Varriun/mag_deck/CAD_outshell/WhatsApp Image 2026-05-17 at 13.24.43.jpeg

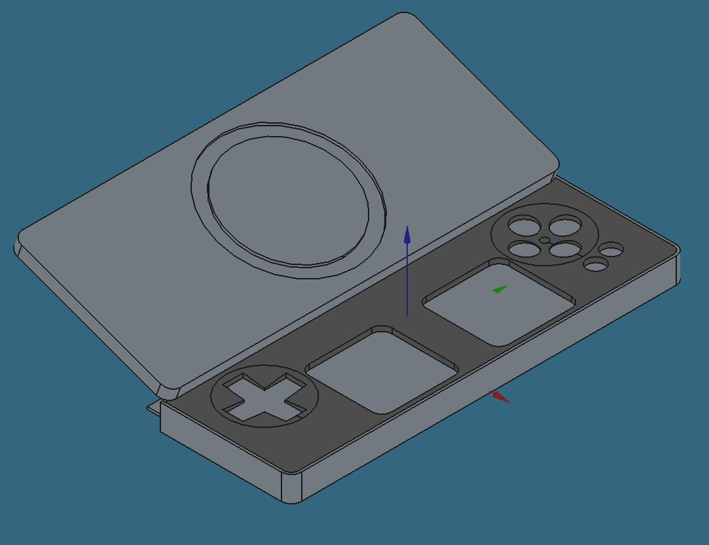
CAD_outshell/WhatsApp Image 2026-05-17 at 13.24.43.jpeg
