Varriun/mag_deck/mag_deck_v2_BOM.xlsx

mag_deck v2 — Bill of Materials (single-unit prototype)
Prices are single/low-qty hobbyist pricing (Digikey/Mouser/LCSC/keycapsss/Amazon), Aug 2026. Bulk pricing will be significantly lower. See Notes column for sourcing.
Module | Item | Part No. / Source | Qty | Unit Price (USD) | Subtotal (USD) | Notes
Bottom Module (Input / Trackpad Board)
Bottom | Cirque GlidePoint Circle Trackpad, 35mm, I2C variant (incl. FFC cable + I2C adapter PCB) | KC10079_35-C (keycapsss.com) | 2 | $23.50 | $47.00 | I2C addr fixed 0x2A / 0x2C via resistor mod — matches existing RTL. Confirm onboard click-button GPIO pins for L3/R3 in full Pinnacle datasheet before finalizing.
Bottom | 16-bit I2C GPIO expander (buttons) | MCP23017-E/SO (Digikey) | 1 | $1.62 | $1.62 | Reads all 14 discrete buttons over I2C; frees the connector from parallel GPIO lines.
Bottom | Tactile momentary switches — ABXY(4), D-pad(4), bumpers(2), triggers(2), start/select(2) | Generic SMD tactile switch | 14 | $0.15 | $2.10 | L3/R3 click is NOT here — comes from Cirque Pinnacle's own button pins, not the expander.
Bottom | Board-to-board pogo pin connector (4–5 pin: VCC/GND/SDA/SCL/+INT) | TBD — pending connector spec (Task 1) | 1 | $2.50 | $2.50 | Mates across the slide/hinge joint to top module.
Bottom | Bottom module PCB fab (lot of 5) | TBD fab house (JLCPCB-class) | 1 | $8.00 | $8.00 | Per-board cost amortized from a small fab run.
Top Module (BLE MCU / Power Board)
Top | nRF52840 BLE module | Raytac MDBT50Q-P1MV2 (Digikey) | 1 | $6.00 | $6.00 | Pre-certified module — avoids RF layout/certification risk of a bare-chip design.
Top | N52 ring magnet array (MagSafe-style attach) | Generic N52 ring magnet set | 1 | $6.00 | $6.00 | For phone attachment, separate from board-to-board connector magnets (if used).
Top | 32.768kHz crystal (BLE low-frequency clock) | Generic tuning-fork crystal, 12.5pF | 1 | $0.30 | $0.30 | Improves BLE timing accuracy/power vs. internal RC oscillator.
Top | Passives (decoupling caps, antenna matching network, pull-ups) | Assorted 0402/0603 passives | 1 | $3.00 | $3.00 | Lumped estimate — refine once schematic is placed.
Top | Power switch | Generic SMD slide/tactile power switch | 1 | $0.60 | $0.60 | Optional now that there is no battery to gate — just an on/off for the USB-powered board. Confirm still wanted before ordering.
Top | Top module PCB fab (lot of 5) | TBD fab house (JLCPCB-class) | 1 | $8.00 | $8.00 | Per-board cost amortized from a small fab run.
 |  |  |  | TOTAL (single prototype unit) | $85.12
