Varriun/mag_deck/CAD/backPlate.FCStd

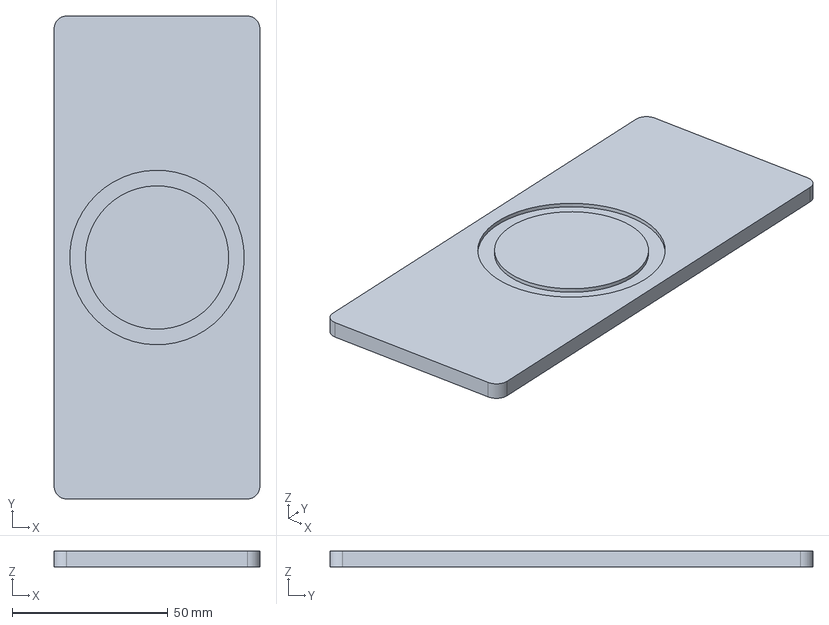
[picture p3: CAD file, 2026-11-06]
CAD/backPlate.FCStd
66.0 x 155.0 x 5.00 mm
