Varriun/mag_deck/CAD/MCON_Fold8_Mockup-DeployPlate.stl

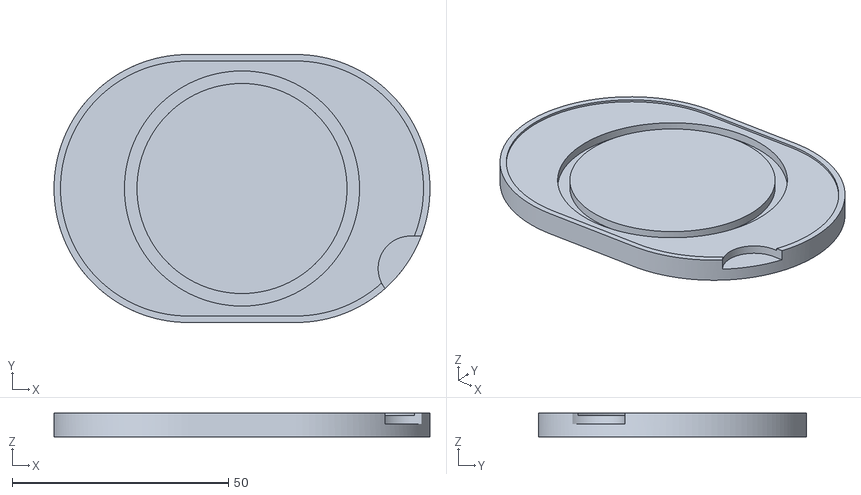
[picture p4: CAD file, 2026-11-06]
CAD/MCON_Fold8_Mockup-DeployPlate.stl
87.0 x 62.0 x 5.50
