Varriun/mag_deck/CAD/shell.FCStd

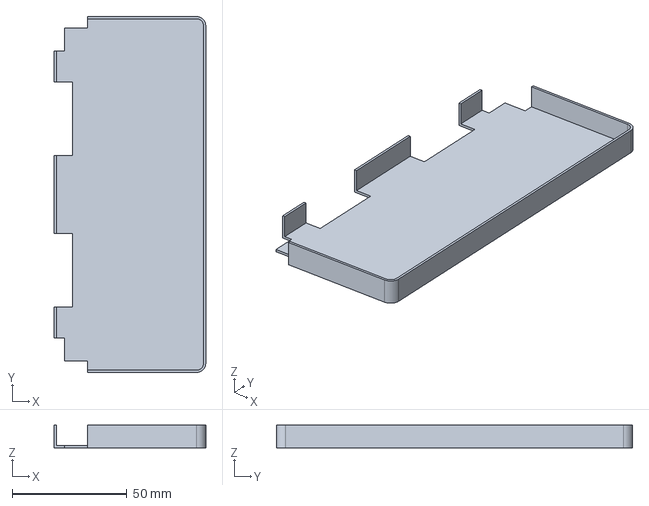
[picture p5: CAD file, 2026-11-06]
CAD/shell.FCStd
66.0 x 155.0 x 10.0 mm
