Varriun/mag_deck/CAD/MCON_Fold8_Mockup.FCStd

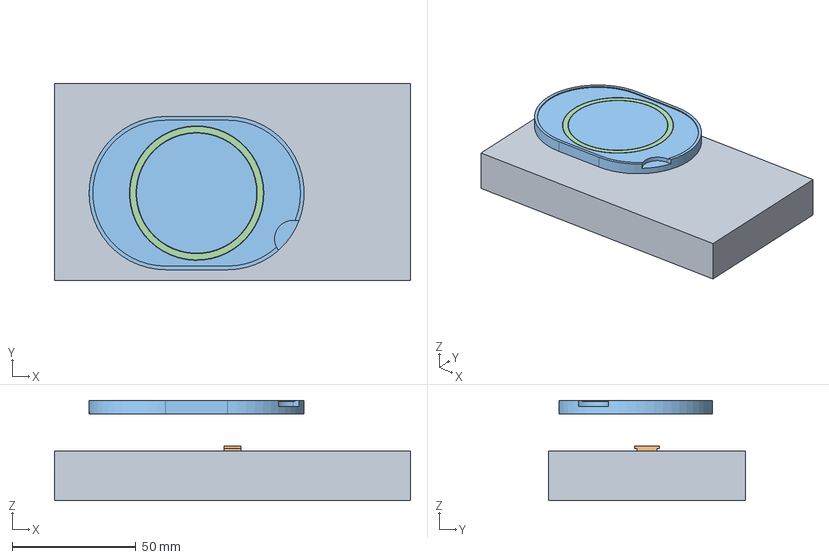
[picture p6: CAD file, 2026-11-06]
CAD/MCON_Fold8_Mockup.FCStd
144.0 x 79.5 x 40.5 mm
Controller
GripNub
Plate
MagnetRing
