Varriun/mag_deck/CAD/frontPlate.FCStd

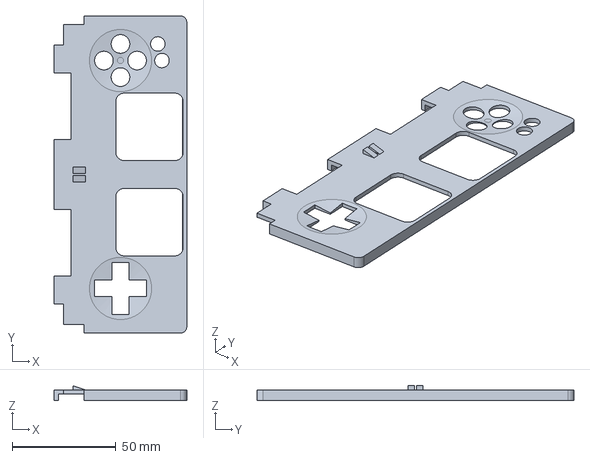
[picture p7: CAD file, 2026-11-06]
CAD/frontPlate.FCStd
64.0 x 153.0 x 7.00 mm
