Varriun/mag_deck/CAD/MCON_Fold8_Mockup6.FCStd

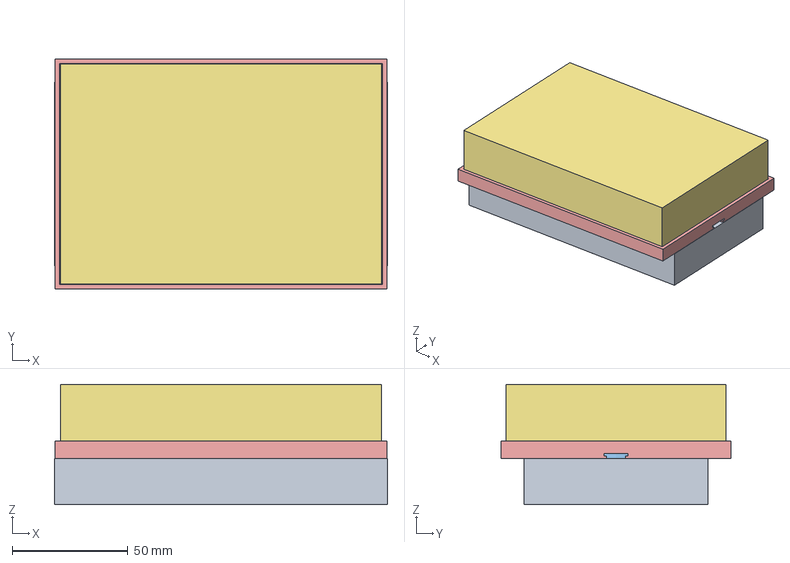
[picture p8: CAD file, 2026-11-06]
CAD/MCON_Fold8_Mockup6.FCStd
144.0 x 99.6 x 52.0 mm
Controller
GripNub
StockPuck
StockPuckRing
Plate
MagnetRing
Fold8Case
CameraBump
