Varriun/mag_deck/(list of files, cad)

Other CAD files:
CAD/controller.FCStd
CAD/faceButton.FCStd
CAD/dpad.FCStd
CAD/bumper.FCStd
