Varriun/mag_deck/(list of files, drawings)

Other design files:
PCB_Project/MAGDECK.SchDoc
PCB_Project/PCB_Project.PrjPcb
