Varriun/mag_deck/testBenches/core_boot_tb.sv

`default_nettype none
// Testbench-only: plain `always` (clock/monitors) and `===` (X-aware checks)
// are correct here; these two rules target synthesizable RTL.
/* svlint off keyword_forbidden_always */
/* svlint off operator_case_equality */
`timescale 1ns/1ps

// ─────────────────────────────────────────────────────────────────────────────
// Integration testbench for mag_deck_core
// Exercises the full pipeline: buttons → debounce → input_mapper → tx_encoder → uart_tx
//
// HOW TO COMPILE AND RUN (from the mag_deck directory):
//   iverilog -g2012 -o core_sim.vvp \
//     testBenches/core_boot_tb.sv \
//     unit/mag_deck_core.sv unit/debounce.sv unit/i2c_master.sv \
//     unit/input_mapper.sv unit/tx_encoder.sv unit/uart_tx.sv
//   vvp core_sim.vvp
//   gtkwave core_boot.vcd
//
// WHAT TO LOOK FOR IN GTKWAVE:
//   dut.clean_face_btn     — settles after THRESHOLD cycles from stable press
//   dut.poll_tick          — pulses every 500K cycles (10 ms)
//   i2c_scl_1 / i2c_scl_2 — toggle after each poll_tick (masters start transaction)
//   tx_pin                 — UART frames appear after each poll_tick
//   dut.enc.state          — steps IDLE→START→WAIT×5→IDLE per packet
//   dut.uart.state         — steps IDLE→START→DATA→STOP per byte
// ─────────────────────────────────────────────────────────────────────────────

module core_boot_tb();

  // ── Parameters ────────────────────────────────────────────────────────────
  localparam int CLK_FREQ        = 50_000_000;
  localparam int BAUD_RATE       = 115_200;
  localparam int DIVISOR         = CLK_FREQ / BAUD_RATE;  // 434 cycles per bit
  localparam int HALF_BIT        = DIVISOR / 2;            // 217
  localparam int DEBOUNCE_THRESH = 50_000;

  // ── Inputs ────────────────────────────────────────────────────────────────
  logic       clk        = 1'b0;
  logic       rst_n      = 1'b0;
  logic [3:0] face_btn   = 4'b0000;
  logic [3:0] dpad       = 4'b0000;
  logic [1:0] bumpers    = 2'b00;
  logic       start_btn  = 1'b0;
  logic       select_btn = 1'b0;
  logic [1:0] triggers   = 2'b00;

  // ── I2C ───────────────────────────────────────────────────────────────────
  // pullup models the physical pull-up resistors on the I2C bus.
  // No slave is modelled — masters will attempt transactions and see NACK.
  logic i2c_scl_1, i2c_scl_2;
  tri   i2c_sda_1, i2c_sda_2;
  pullup pu1 (i2c_sda_1);
  pullup pu2 (i2c_sda_2);

  // ── UART output ───────────────────────────────────────────────────────────
  logic tx_pin;

  // ── DUT ───────────────────────────────────────────────────────────────────
  mag_deck_core dut (
    .clk        (clk),
    .rst_n      (rst_n),
    .face_btn   (face_btn),
    .dpad       (dpad),
    .bumpers    (bumpers),
    .start_btn  (start_btn),
    .select_btn (select_btn),
    .triggers   (triggers),
    .i2c_scl_1  (i2c_scl_1),
    .i2c_sda_1  (i2c_sda_1),
    .i2c_scl_2  (i2c_scl_2),
    .i2c_sda_2  (i2c_sda_2),
    .tx_pin     (tx_pin)
  );

  // ── 50 MHz clock ──────────────────────────────────────────────────────────
  always #10 clk = ~clk;

  // ── Diagnostics ───────────────────────────────────────────────────────────
  always @(posedge dut.tx_start)
    $display("  DIAG  tx_start pulse: tx_byte=0x%02X  t=%0t", dut.tx_byte, $time);

  always @(negedge tx_pin)
    $display("  DIAG  tx_pin negedge  t=%0t", $time);

  // ── Task: capture one UART byte ───────────────────────────────────────────
  // Call immediately after @(negedge tx_pin) — enters at start of start bit.
  // Skips start bit, samples 8 data bits LSB-first at their midpoints,
  // then leaves sim position near midpoint of stop bit.
  task capture_uart_byte;
    output [7:0] captured;
    integer b;
    begin
      // Advance past start bit and to midpoint of bit 0
      repeat(DIVISOR + HALF_BIT) @(posedge clk); #1;
      // Sample 8 data bits, one bit period apart
      for (b = 0; b < 8; b = b + 1) begin
        captured[b] = tx_pin;
        repeat(DIVISOR) @(posedge clk); #1;
      end
      // Now near midpoint of stop bit — next @(negedge tx_pin) will sync to next byte
    end
  endtask

  // ── Scoreboard: check()/check_byte()/report_and_finish() + watchdog ──────
  // Full run is ~20.1 ms; the watchdog fails the test at 30 ms.
  localparam string TB_NAME    = "core_boot_tb";
  localparam int    TIMEOUT_NS = 30_000_000;
`include "testBenches/tb_checks.svh"

  // ── I2C activity monitor ──────────────────────────────────────────────────
  // Counts SCL rising edges so PHASE 9 can check the masters actually clocked
  // the bus, instead of sampling SCL once.
  int scl1_edges = 0;
  int scl2_edges = 0;
  always @(posedge i2c_scl_1) scl1_edges++;
  always @(posedge i2c_scl_2) scl2_edges++;
  int scl1_at_tick, scl2_at_tick;

  // ── Stimulus ──────────────────────────────────────────────────────────────
  logic [7:0] byte_cap;

  initial begin
    $dumpfile("core_boot.vcd");
    $dumpvars(0, core_boot_tb);

    // ── PHASE 1: Reset ────────────────────────────────────────────────────
    $display("\n── PHASE 1: Reset ──");
    rst_n = 1'b0;
    repeat(4) @(posedge clk);
    rst_n = 1'b1;
    repeat(2) @(posedge clk); #1;
    check(tx_pin === 1'b1, "tx_pin idle high after reset");

    // ── PHASE 2: Bounce then stable inputs ───────────────────────────────
    // Bounce on face_btn[1]; stable inputs settle on face_btn[0] + others.
    // Expected packet values:
    //   pkt[1] = {2'b0, triggers=01, start=1, select=0, bumpers=01} = 0x19
    //   pkt[2] = {face_btn=0001, dpad=0001}             = 0x11
    $display("\n── PHASE 2: Bounce + stable inputs ──");
    @(posedge clk); face_btn[1] = 1'b1;
    @(posedge clk); face_btn[1] = 1'b0;
    @(posedge clk); face_btn[1] = 1'b1;
    @(posedge clk); face_btn[1] = 1'b0;
    @(posedge clk);
    face_btn  = 4'b0001;
    dpad      = 4'b0001;
    bumpers   = 2'b01;
    start_btn = 1'b1;
    triggers  = 2'b01;
    $display("  Inputs: face=0001 dpad=0001 bumpers=01 start=1 triggers=01");

    // ── PHASE 3: Debounce settle ──────────────────────────────────────────
    $display("\n── PHASE 3: Debounce settle ──");
    repeat(DEBOUNCE_THRESH + 500) @(posedge clk); #1;
    check(dut.clean_face_btn === 4'b0001,
          $sformatf("clean_face_btn = %b (expected 0001, bounce filtered)",
                    dut.clean_face_btn));
    check(dut.clean_start_btn === 1'b1,
          $sformatf("clean_start_btn = %b (expected 1)", dut.clean_start_btn));

    // ── PHASE 4: Wait for poll_tick ───────────────────────────────────────
    // tx_pin goes low ~2 cycles after poll_tick — go straight to @(negedge)
    // with no added delay so we don't miss the first start bit.
    $display("\n── PHASE 4: Waiting for poll_tick ──");
    @(posedge dut.poll_tick);
    scl1_at_tick = scl1_edges;
    scl2_at_tick = scl2_edges;
    #1;
    $display("  poll_tick fired  pkt={0x%02X,0x%02X,0x%02X,0x%02X,0x%02X}",
             dut.pkt[0], dut.pkt[1], dut.pkt[2], dut.pkt[3], dut.pkt[4]);

    // ── PHASE 5: UART byte 0 — sync (0xAA) ───────────────────────────────
    $display("\n── PHASE 5: UART byte 0 (sync) ──");
    @(negedge tx_pin);
    capture_uart_byte(byte_cap);
    check_byte(byte_cap, 8'hAA, "byte[0] sync");

    // ── PHASE 6: UART byte 1 — buttons (0x19) ────────────────────────────
    $display("\n── PHASE 6: UART byte 1 (buttons) ──");
    @(negedge tx_pin);
    capture_uart_byte(byte_cap);
    check_byte(byte_cap, 8'h19, "byte[1] btns");

    // ── PHASE 7: UART byte 2 — face + dpad (0x11) ────────────────────────
    $display("\n── PHASE 7: UART byte 2 (face+dpad) ──");
    @(negedge tx_pin);
    capture_uart_byte(byte_cap);
    check_byte(byte_cap, 8'h11, "byte[2] face+dpad");

    // ── PHASE 8: UART bytes 3,4 — trackpad data ───────────────────────────
    // No I2C slave model — tp_data stays at 0x00 (reset value).
    $display("\n── PHASE 8: UART bytes 3,4 (trackpad, no slave) ──");
    @(negedge tx_pin);
    capture_uart_byte(byte_cap);
    check_byte(byte_cap, 8'h00, "byte[3] tp_data_1 (no slave)");

    @(negedge tx_pin);
    capture_uart_byte(byte_cap);
    check_byte(byte_cap, 8'h00, "byte[4] tp_data_2 (no slave)");

    // ── PHASE 9: I2C SCL activity ─────────────────────────────────────────
    // UART transmission just finished (~21K cycles since poll_tick).
    // I2C masters (100kHz, 500 cycles/bit) have had plenty of time to start.
    // Check SCL actually clocked since poll_tick (edge count, not one sample).
    $display("\n── PHASE 9: I2C SCL activity ──");
    repeat(10) @(posedge clk); #1;
    check(scl1_edges > scl1_at_tick,
          $sformatf("i2c_scl_1 clocked after poll_tick (%0d rising edges)",
                    scl1_edges - scl1_at_tick));
    check(scl2_edges > scl2_at_tick,
          $sformatf("i2c_scl_2 clocked after poll_tick (%0d rising edges)",
                    scl2_edges - scl2_at_tick));

    // ── PHASE 10: Pipeline idle check ────────────────────────────────────
    $display("\n── PHASE 10: Pipeline idle check ──");
    repeat(DIVISOR + 20) @(posedge clk); #1;
    check(dut.tx_busy === 1'b0, "tx_busy low — pipeline in IDLE");
    check(tx_pin === 1'b1,      "tx_pin idle high");

    // ── PHASE 11: Second packet on next poll_tick ─────────────────────────
    $display("\n── PHASE 11: Second packet ──");
    @(posedge dut.poll_tick);
    @(negedge tx_pin);
    capture_uart_byte(byte_cap);
    check_byte(byte_cap, 8'hAA, "pkt2 byte[0] sync");

    $display("\n── Integration sim complete ──");
    report_and_finish();
  end

endmodule

`default_nettype wire
