Varriun/mag_deck/testBenches/input_mapper_tb.sv

`default_nettype none
// Testbench-only: plain `always` (clock/monitors) and `===` (X-aware checks)
// are correct here; these two rules target synthesizable RTL.
/* svlint off keyword_forbidden_always */
/* svlint off operator_case_equality */
`timescale 1ns/1ps

// ─────────────────────────────────────────────────────────────────────────────
// Testbench for input_mapper.sv
//
// Three checks:
//   1. All-zeros: every data byte should be 0x00; pkt[0] always 0xAA.
//   2. Known pattern: drive recognisable values, verify each byte by hand.
//   3. pkt_valid strobe: assert poll_tick for one cycle, confirm pkt_valid
//      goes high for exactly that cycle then returns to 0.
//
// HOW TO COMPILE AND RUN (from the mag_deck directory):
//   iverilog -g2012 -o input_mapper_tb.vvp testBenches/input_mapper_tb.sv unit/input_mapper.sv
//   vvp input_mapper_tb.vvp
//   gtkwave input_mapper_tb.vcd
//
// WHAT TO LOOK FOR IN GTKWAVE:
//   pkt[0]     — should always be 0xAA
//   pkt[1]     — spare[1:0] | triggers[1:0] | start | select | bumpers[1:0]
//   pkt[2]     — face_btn[3:0] | dpad[3:0]
//   pkt[3/4]   — raw trackpad bytes
//   pkt_valid  — one-cycle pulse aligned with poll_tick
// ─────────────────────────────────────────────────────────────────────────────

module input_mapper_tb();

  // ── Inputs to DUT ─────────────────────────────────────────────────────────
  logic       clk        = 1'b0;
  logic       rst_n      = 1'b0;
  logic [3:0] face_btn   = 4'b0;
  logic [3:0] dpad       = 4'b0;
  logic [1:0] bumpers    = 2'b0;
  logic       start_btn  = 1'b0;
  logic       select_btn = 1'b0;
  logic [1:0] triggers   = 2'b00;
  logic [7:0] tp_data_1  = 8'h00;
  logic [7:0] tp_data_2  = 8'h00;
  logic       poll_tick  = 1'b0;

  // ── Outputs from DUT ──────────────────────────────────────────────────────
  logic [7:0] pkt [0:4];
  logic       pkt_valid;

  // ── DUT instantiation ─────────────────────────────────────────────────────
  input_mapper dut (
    .clk        (clk),
    .rst_n      (rst_n),
    .face_btn   (face_btn),
    .dpad       (dpad),
    .bumpers    (bumpers),
    .start_btn  (start_btn),
    .select_btn (select_btn),
    .triggers   (triggers),
    .tp_data_1  (tp_data_1),
    .tp_data_2  (tp_data_2),
    .poll_tick  (poll_tick),
    .pkt        (pkt),
    .pkt_valid  (pkt_valid)
  );

  // ── 50 MHz clock (20 ns period) ───────────────────────────────────────────
  always #10 clk = ~clk;

  // ── Scoreboard: check()/check_byte()/report_and_finish() + watchdog ──────
  // Whole run is ~200 ns; the watchdog fails the test at 10 us.
  localparam string TB_NAME    = "input_mapper_tb";
  localparam int    TIMEOUT_NS = 10_000;
`include "testBenches/tb_checks.svh"

  // ── Stimulus ──────────────────────────────────────────────────────────────
  initial begin
    $dumpfile("input_mapper_tb.vcd");
    $dumpvars(0, input_mapper_tb);

    repeat(4) @(posedge clk);
    rst_n = 1'b1;
    repeat(2) @(posedge clk);

    // ── Check 1: All-zeros ────────────────────────────────────────────────
    // pkt is combinational — outputs are valid immediately after inputs settle.
    #1;
    $display("\n── Check 1: all-zeros ──");
    check_byte(pkt[0], 8'hAA, "pkt[0]");
    check_byte(pkt[1], 8'h00, "pkt[1]");
    check_byte(pkt[2], 8'h00, "pkt[2]");
    check_byte(pkt[3], 8'h00, "pkt[3]");
    check_byte(pkt[4], 8'h00, "pkt[4]");

    // ── Check 2: Known pattern ────────────────────────────────────────────
    //
    // Drive recognisable values so you can verify the packing by hand:
    //   face_btn  = 4'b1010  (A and X pressed)
    //   dpad      = 4'b0101  (down and right)
    //   bumpers   = 2'b10    (L1 pressed, R1 not)
    //   triggers  = 2'b10    (triggers[1] pressed, triggers[0] not)
    //   start_btn = 1,  select_btn = 0
    //   tp_data_1 = 0xDE,  tp_data_2 = 0xAD
    //
    // Work out the expected bytes yourself before looking at the checks:
    //   pkt[1] = {2'b00, triggers, start, select, bumpers} = ?
    //   pkt[2] = {face_btn, dpad}                  = ?

    face_btn   = 4'b1010;
    dpad       = 4'b0101;
    bumpers    = 2'b10;
    start_btn  = 1'b1;
    select_btn = 1'b0;
    triggers   = 2'b10;
    tp_data_1  = 8'hDE;
    tp_data_2  = 8'hAD;
    #1;

    $display("\n── Check 2: known pattern ──");
    check_byte(pkt[0], 8'hAA, "pkt[0]");  // sync never changes
    check_byte(pkt[1], 8'h2A, "pkt[1]");  // 00 | 10 | 1 | 0 | 10  = 0x2A
    check_byte(pkt[2], 8'hA5, "pkt[2]");  // 1010 | 0101        = 0xA5
    check_byte(pkt[3], 8'hDE, "pkt[3]");
    check_byte(pkt[4], 8'hAD, "pkt[4]");

    // ── Check 2b: other trigger bit ───────────────────────────────────────
    // Flip which trigger is pressed. Together with Check 2 this proves each
    // trigger lands in its own bit — a swapped L2/R2 order would fail here.
    triggers = 2'b01;
    #1;
    $display("\n── Check 2b: triggers = 01 ──");
    check_byte(pkt[1], 8'h1A, "pkt[1]");  // 00 | 01 | 1 | 0 | 10  = 0x1A

    // ── Check 3: pkt_valid strobe ─────────────────────────────────────────
    // Assert poll_tick for exactly one clock cycle.
    // pkt_valid must go high on that same cycle, then return to 0.

    $display("\n── Check 3: pkt_valid strobe ──");
    @(posedge clk);
    poll_tick = 1'b1;
    @(posedge clk);
    #1;
    check(pkt_valid === 1'b1, "pkt_valid high while poll_tick asserted");

    poll_tick = 1'b0;
    @(posedge clk);
    #1;
    check(pkt_valid === 1'b0, "pkt_valid returned low after poll_tick released");

    report_and_finish();
  end

endmodule

`default_nettype wire
