Varriun/mag_deck/(commit log)

2026-11-06 Consolidate local MAGDECK into repo
    Add v2 README, BOM, mount sketch, FreeCAD models, Altium schematic project.
    Remove tracked sim output (.vcd/.vvp); replace misspelled .gitgnore with .gitignore; add .gitattributes.
2026-11-06 Self-checking testbenches, lint config, fix i2c_master_tb pull-up
    - Add .svlint.toml (designintent ruleset, minus opinionated style rules)
    - Fix svlint warnings: default_nettype, typed localparams, case defaults,
    begin/end on multi-line ifs, wire->logic/tri, genvar-in-loop
    - Fix i2c_master_tb: model SDA pull-up (tri1); 1-bits were reading as Z
    - Add testBenches/tb_checks.svh: shared scoreboard with check counts,
    PASS/FAIL summary, non-zero exit on failure, watchdog
    - Convert all 5 testbenches to it; remove 2 unconditional PASS prints in
    uart_tx_tb; check trackpad bytes, SCL activity, rx_valid strobe, STOP
    - Add run_tests.sh to run every testbench
2026-11-06 Remove empty stubs: mag_deck_top_tb (no top module yet), analog_sampler (triggers are digital, trackpads are I2C)
2026-11-06 Rewrite README; non-blocking counter updates in uart_tx/tx_encoder
